digitarhythm/TReK_withTK/media/BOOTH用/PXL_20240208_152246339.jpg

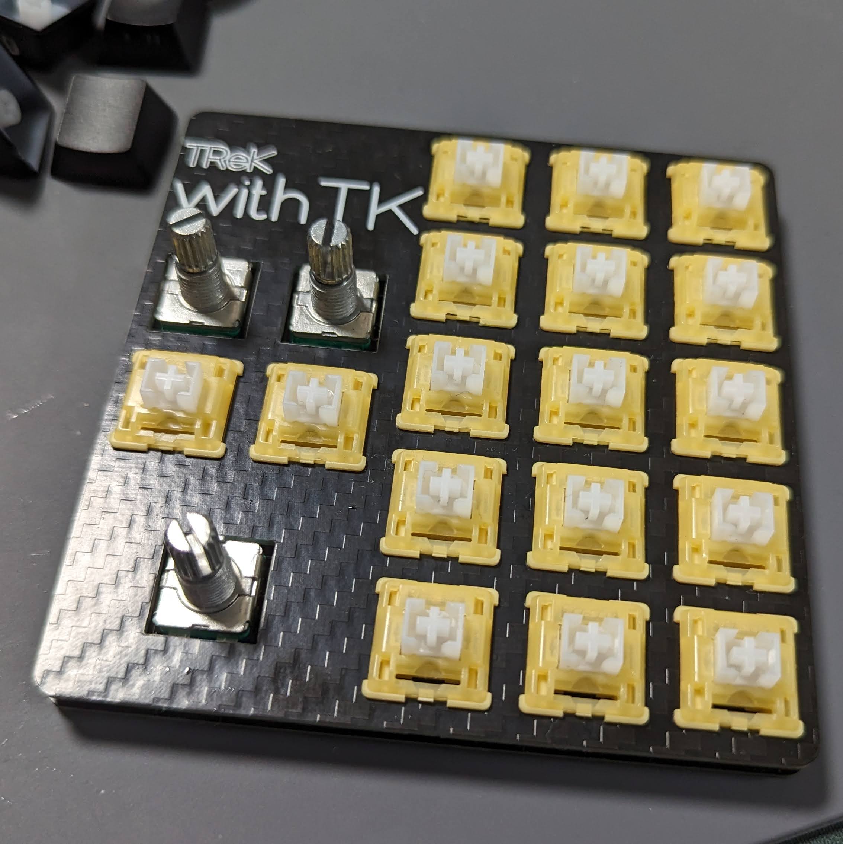
media/BOOTH用/PXL_20240208_152246339.jpg
