digitarhythm/TReK_withTK/media/IMG_20240205_005419.jpg

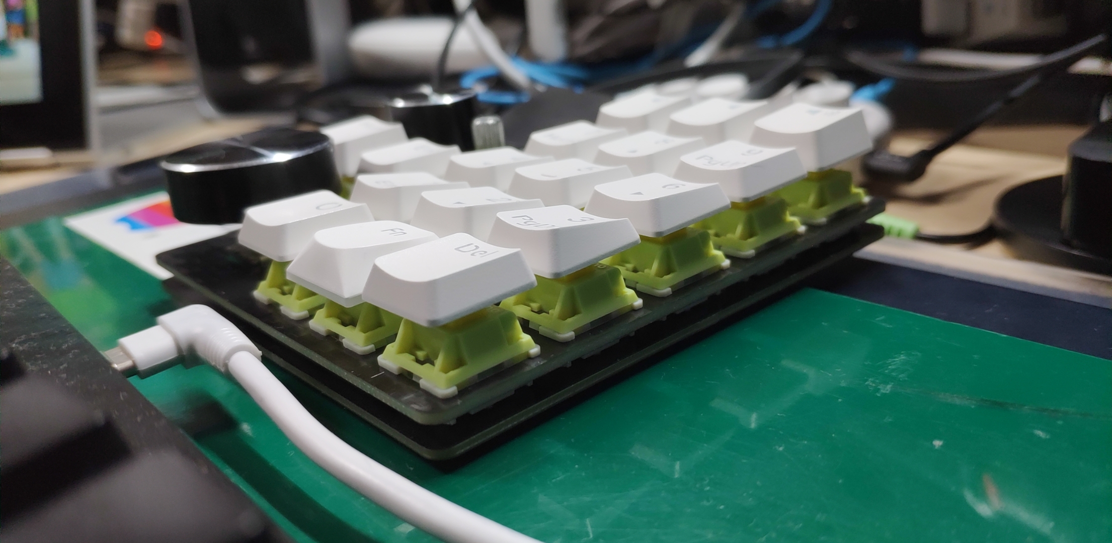
media/IMG_20240205_005419.jpg
