digitarhythm/TReK_withTK/README.md

# TReK withTK
Macropad TenKey pad with RP2040-Zero.

[Firmware repository](https://github.com/digitarhythm/qmk_firmware/tree/digitarhythm/keyboards/trek/withtk)
