digitarhythm/TReK_withTK/media/BOOTH用/IMG_20240203_142107.jpg

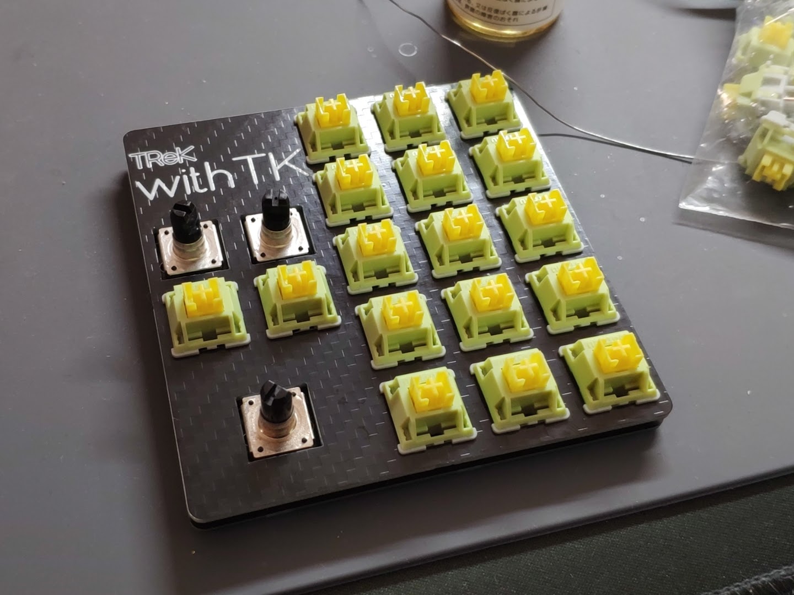
media/BOOTH用/IMG_20240203_142107.jpg
