digitarhythm/TReK_withTK/media/BOOTH用/IMG_20240204_002117.jpg

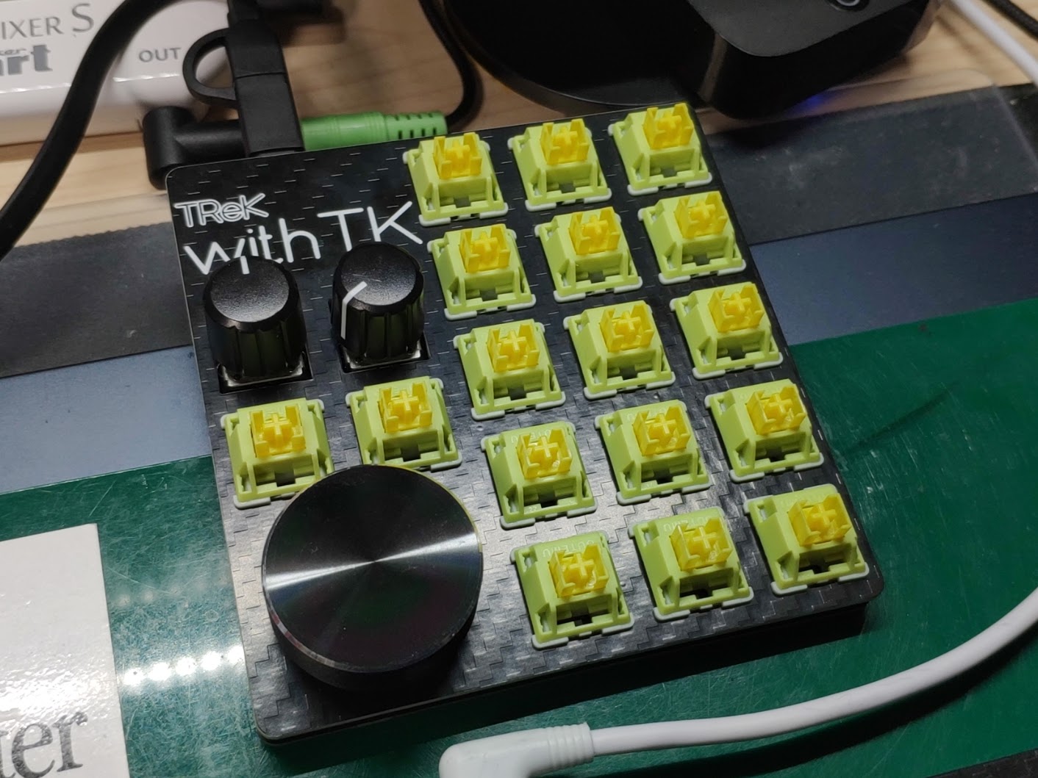
media/BOOTH用/IMG_20240204_002117.jpg
