digitarhythm/TReK_withTK/media/BOOTH用/IMG_20240206_234523.jpg

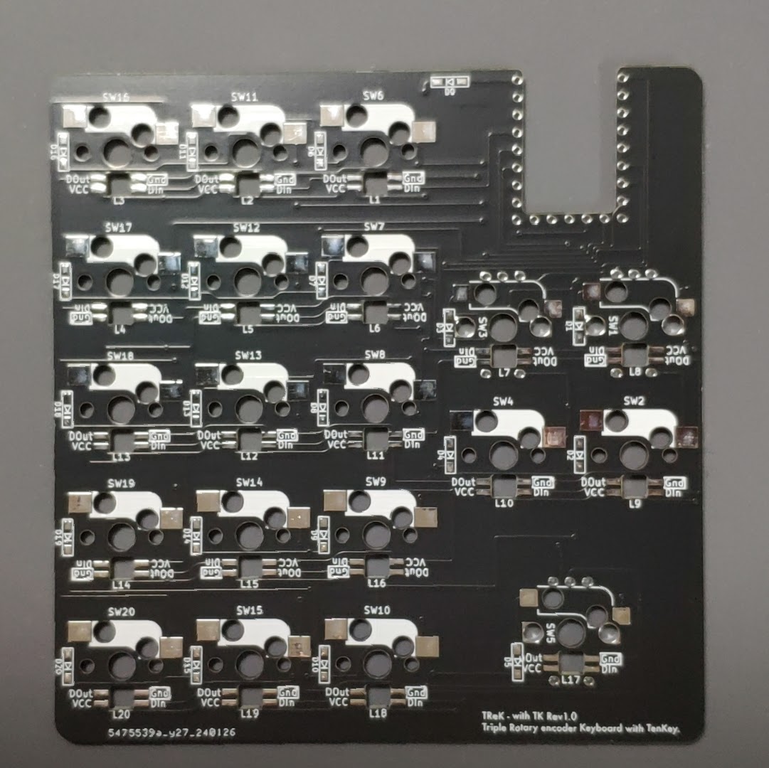
media/BOOTH用/IMG_20240206_234523.jpg
