digitarhythm/TReK_withTK/media/BOOTH用/IMG_20240206_235231.jpg

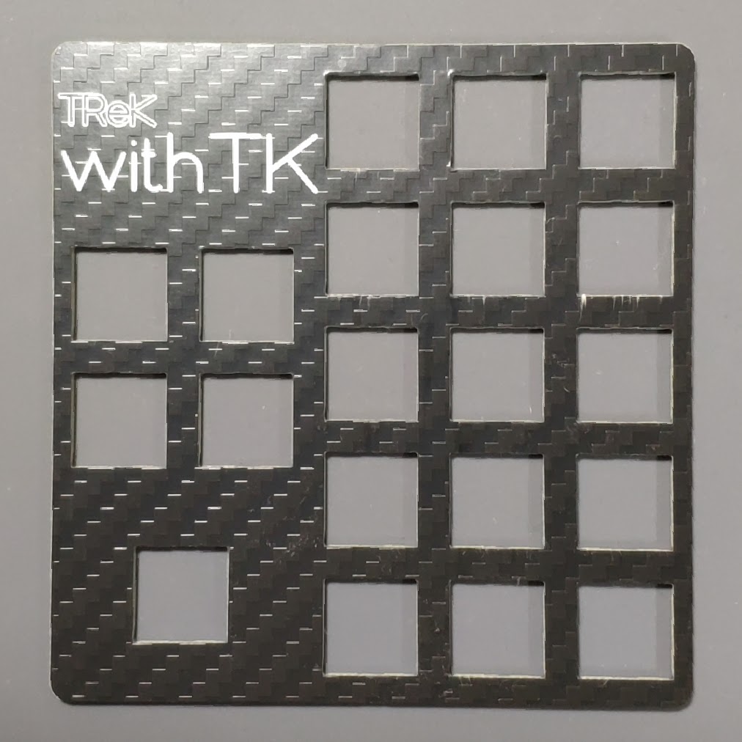
media/BOOTH用/IMG_20240206_235231.jpg
