digitarhythm/TReK_withTK/media/BOOTH用/original_1f7eefd0-b8d7-42fd-86b8-c95d16b6a875_IMG_20240207_214912.jpg

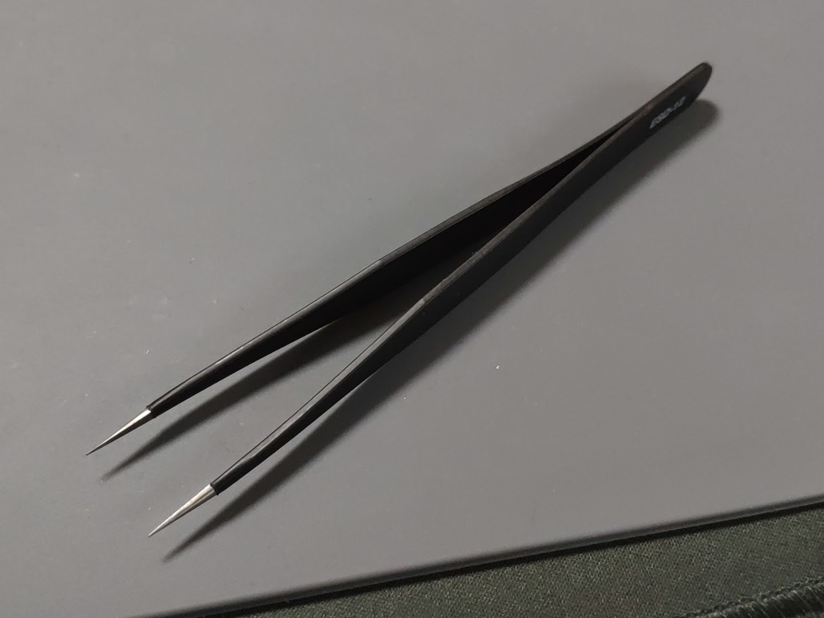
media/BOOTH用/original_1f7eefd0-b8d7-42fd-86b8-c95d16b6a875_IMG_20240207_214912.jpg
