digitarhythm/TReK_withTK/media/BOOTH用/PXL_20240208_113437173.jpg

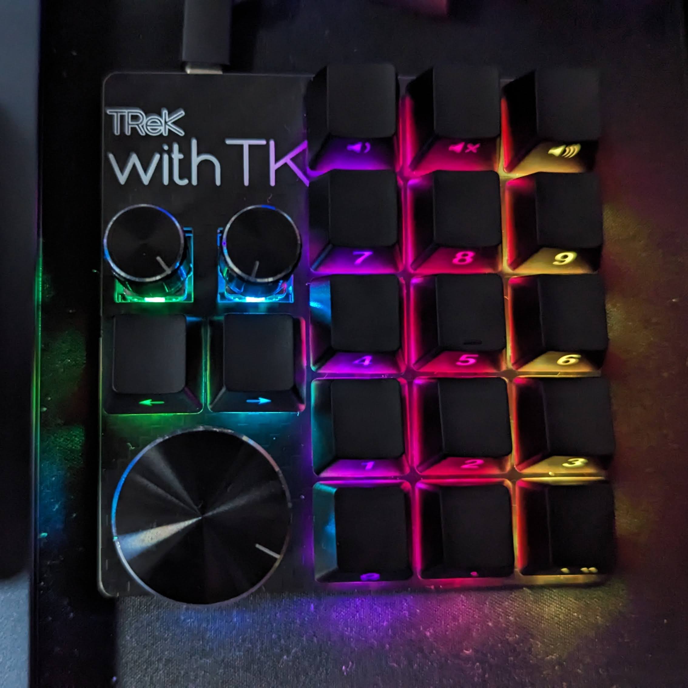
media/BOOTH用/PXL_20240208_113437173.jpg
