digitarhythm/TReK_withTK/media/BOOTH用/PXL_20240208_113447430.jpg

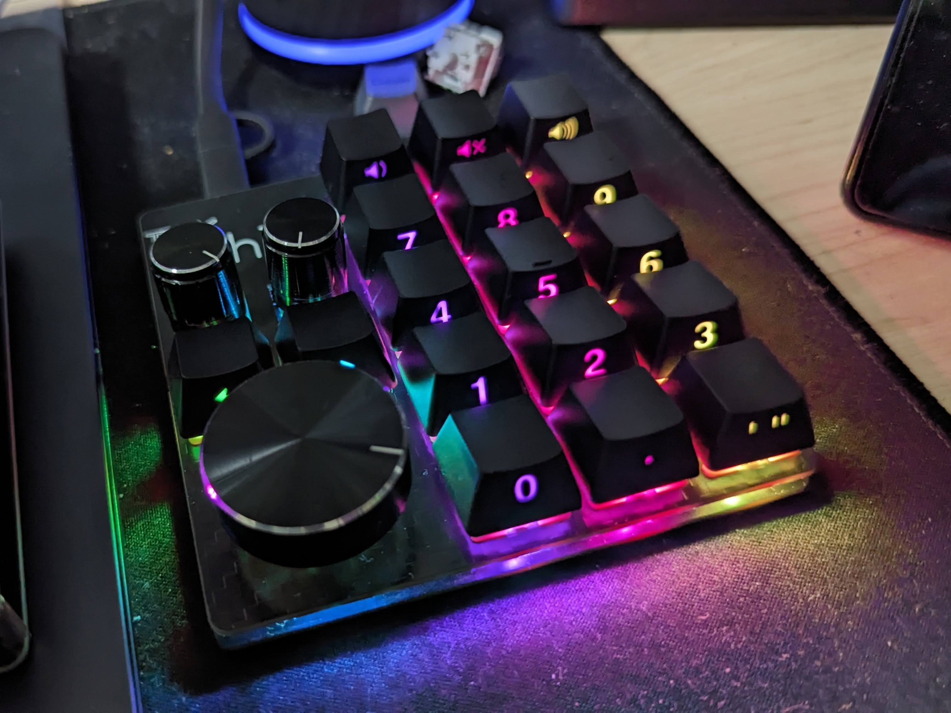
media/BOOTH用/PXL_20240208_113447430.jpg
