digitarhythm/TReK_withTK/media/IMG_20240205_021253.jpg

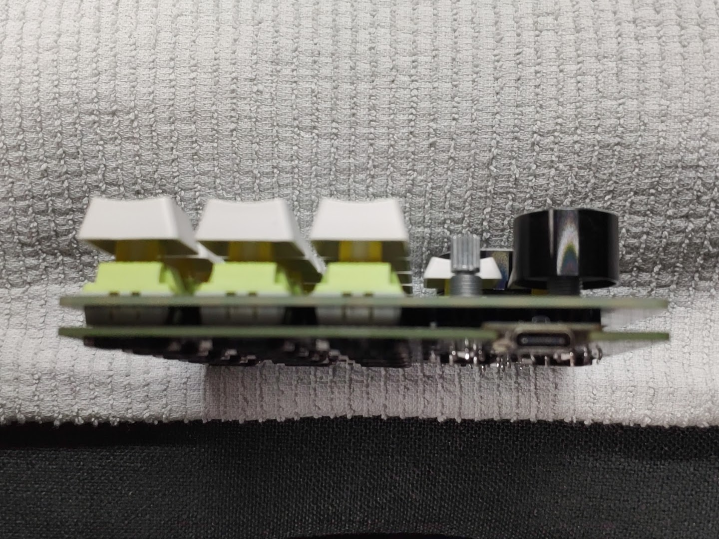
media/IMG_20240205_021253.jpg
