digitarhythm/TReK_withTK/media/withTK.png

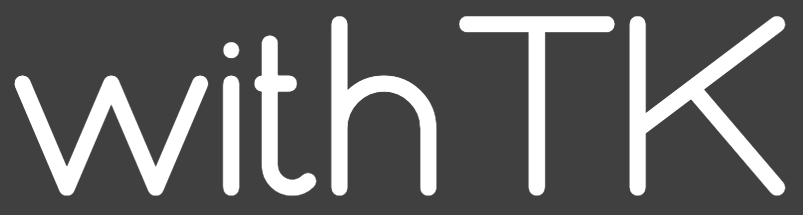
media/withTK.png
