digitarhythm/TReK_withTK/(list of files, drawings)

Other design files:
pcb/withTK.dsn
switch_plate/withTK.dsn
