digitarhythm/TReK_withTK/pcb/withTK.kicad_pcb

## KiCad design pcb/withTK.kicad_pcb (2024-02-04)

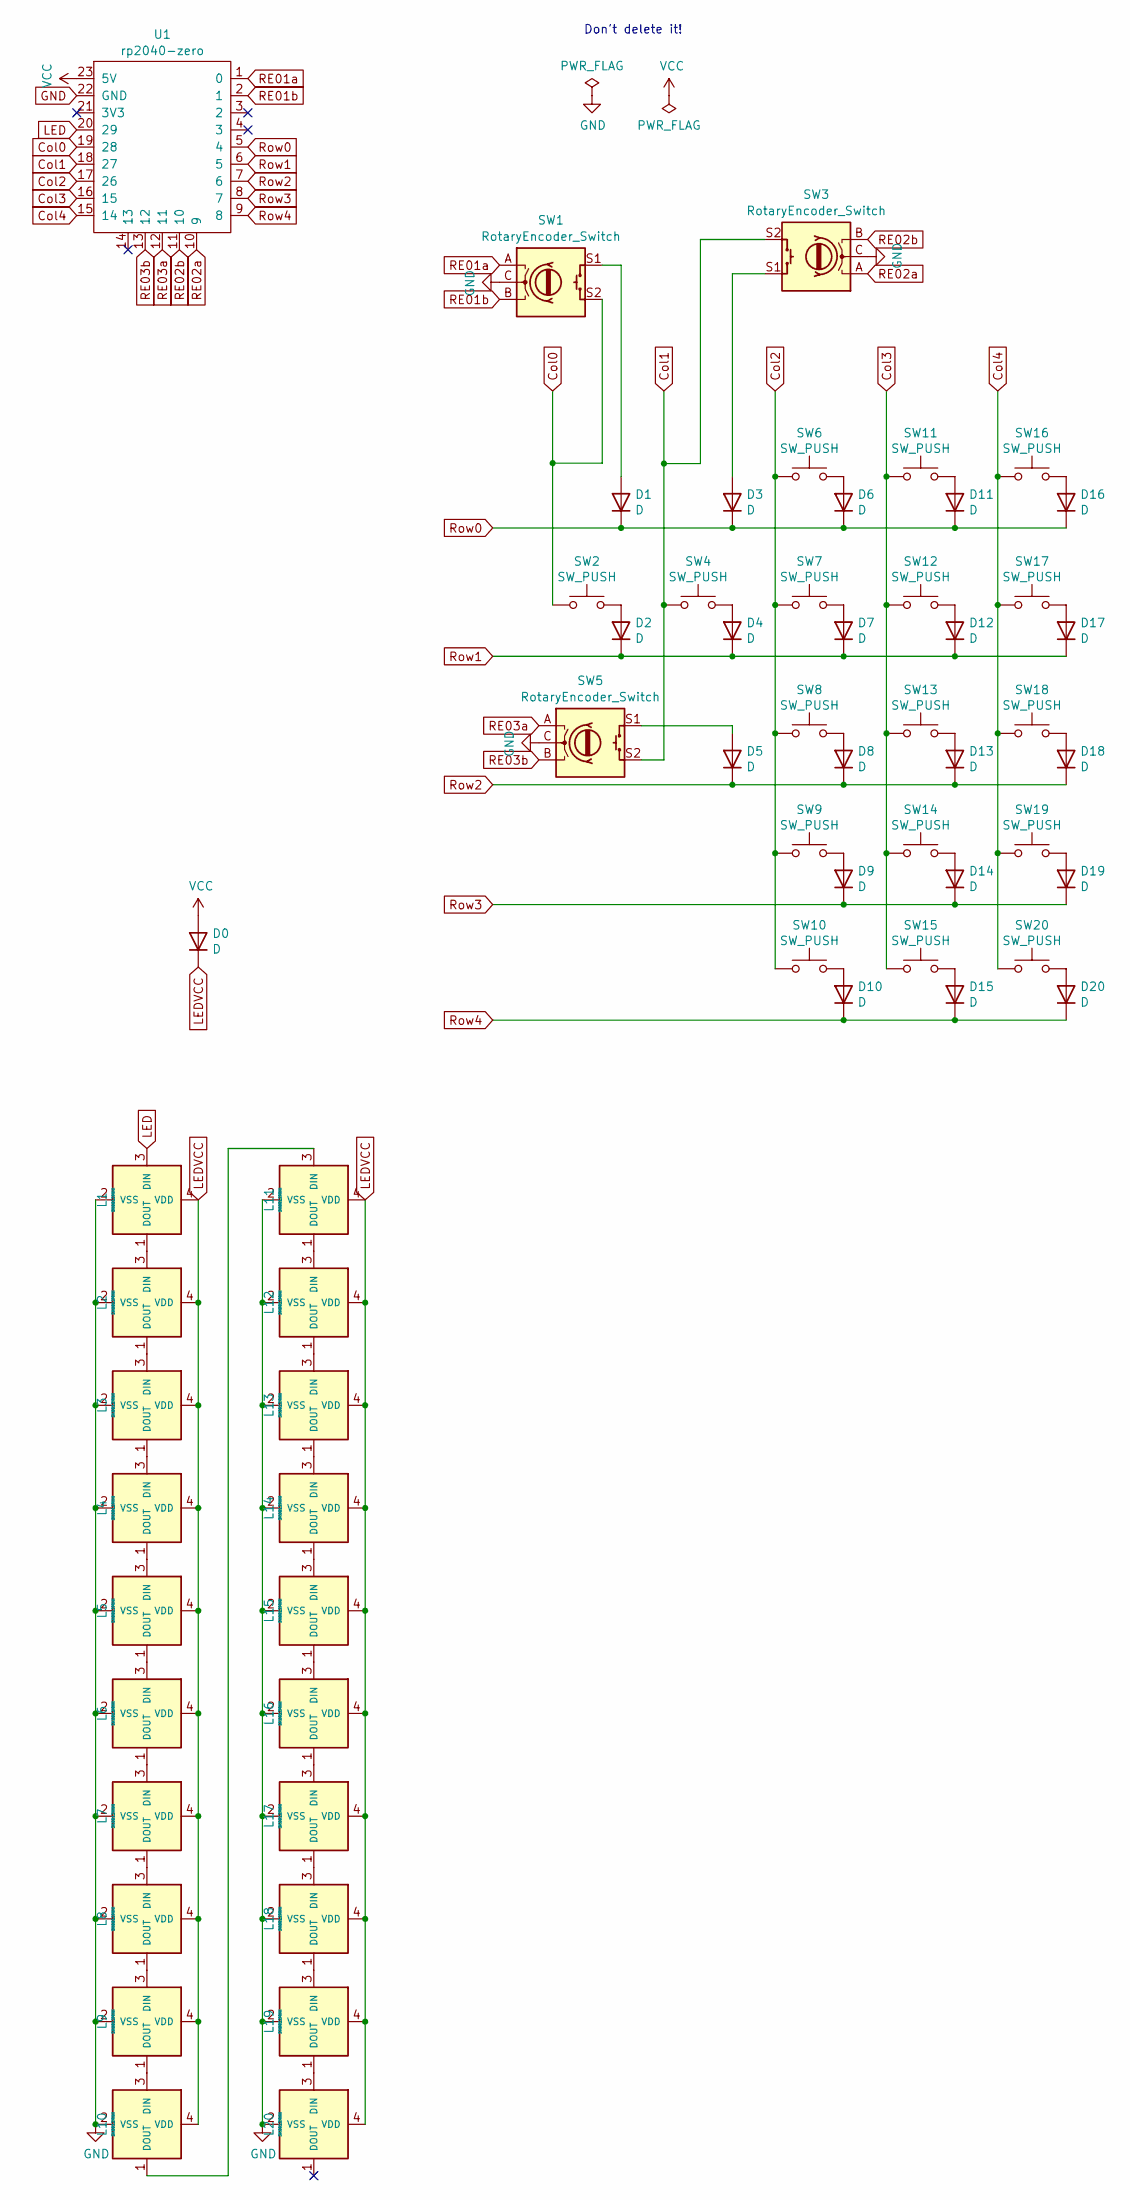
[picture p14: schematic withTK.kicad_sch]

Parts:
D0, D1, D2, D3, D4, D5, D6, D7, D8, D9, D10, D11, D12, D13, D14, D15, D16, D17, D18, D19, D20: D; Diode_SMD
L1, L2, L3, L4, L5, L6, L7, L8, L9, L10, L11, L12, L13, L14, L15, L16, L17, L18, L19, L20: SK6812MINI; LED_SK6812MINI-E_BL
SW1, SW3, SW5: RotaryEncoder_Switch; SW_Cherry_MX_1.00u_Kailh_EC12
SW2, SW4, SW6, SW7, SW8, SW9, SW10, SW11, SW12, SW13, SW14, SW15, SW16, SW17, SW18, SW19, SW20: SW_PUSH; CherryMX_Hotswap_1u
U1: rp2040-zero; rp2040-zero-smd-rev-with-th

Connections:
Col0: SW1.S2, SW2.1, U1.19 (28)
Col1: SW3.S2, SW4.1, SW5.S2, U1.18 (27)
Col2: SW6.1, SW7.1, SW8.1, SW9.1, SW10.1, U1.17 (26)
Col3: SW11.1, SW12.1, SW13.1, SW14.1, SW15.1, U1.16 (15)
Col4: SW16.1, SW17.1, SW18.1, SW19.1, SW20.1, U1.15 (14)
GND: L1.2 (VSS), L2.2 (VSS), L3.2 (VSS), L4.2 (VSS), L5.2 (VSS), L6.2 (VSS), L7.2 (VSS), L8.2 (VSS), L9.2 (VSS), L10.2 (VSS), L11.2 (VSS), L12.2 (VSS), L13.2 (VSS), L14.2 (VSS), L15.2 (VSS), L16.2 (VSS), L17.2 (VSS), L18.2 (VSS), L19.2 (VSS), L20.2 (VSS), SW1.C, SW3.C, SW5.C, U1.22 (GND)
LED: L1.3 (DIN), U1.20 (29)
LEDVCC: D0.1 (K), L1.4 (VDD), L2.4 (VDD), L3.4 (VDD), L4.4 (VDD), L5.4 (VDD), L6.4 (VDD), L7.4 (VDD), L8.4 (VDD), L9.4 (VDD), L10.4 (VDD), L11.4 (VDD), L12.4 (VDD), L13.4 (VDD), L14.4 (VDD), L15.4 (VDD), L16.4 (VDD), L17.4 (VDD), L18.4 (VDD), L19.4 (VDD), L20.4 (VDD)
unnamed: D1.2 (A), SW1.S1
unnamed: D2.2 (A), SW2.2
unnamed: D3.2 (A), SW3.S1
unnamed: D4.2 (A), SW4.2
unnamed: D5.2 (A), SW5.S1
unnamed: D6.2 (A), SW6.2
unnamed: D7.2 (A), SW7.2
unnamed: D8.2 (A), SW8.2
unnamed: D9.2 (A), SW9.2
unnamed: D10.2 (A), SW10.2
unnamed: D11.2 (A), SW11.2
unnamed: D12.2 (A), SW12.2
unnamed: D13.2 (A), SW13.2
unnamed: D14.2 (A), SW14.2
unnamed: D15.2 (A), SW15.2
unnamed: D16.2 (A), SW16.2
unnamed: D17.2 (A), SW17.2
unnamed: D18.2 (A), SW18.2
unnamed: D19.2 (A), SW19.2
unnamed: D20.2 (A), SW20.2
unnamed: L1.1 (DOUT), L2.3 (DIN)
unnamed: L2.1 (DOUT), L3.3 (DIN)
unnamed: L3.1 (DOUT), L4.3 (DIN)
unnamed: L4.1 (DOUT), L5.3 (DIN)
unnamed: L5.1 (DOUT), L6.3 (DIN)
unnamed: L6.1 (DOUT), L7.3 (DIN)
unnamed: L7.1 (DOUT), L8.3 (DIN)
unnamed: L8.1 (DOUT), L9.3 (DIN)
unnamed: L9.1 (DOUT), L10.3 (DIN)
unnamed: L10.1 (DOUT), L11.3 (DIN)
unnamed: L11.1 (DOUT), L12.3 (DIN)
unnamed: L12.1 (DOUT), L13.3 (DIN)
unnamed: L13.1 (DOUT), L14.3 (DIN)
unnamed: L14.1 (DOUT), L15.3 (DIN)
unnamed: L15.1 (DOUT), L16.3 (DIN)
unnamed: L16.1 (DOUT), L17.3 (DIN)
unnamed: L17.1 (DOUT), L18.3 (DIN)
unnamed: L18.1 (DOUT), L19.3 (DIN)
unnamed: L19.1 (DOUT), L20.3 (DIN)
RE01a: SW1.A, U1.1 (0)
RE01b: SW1.B, U1.2 (1)
RE02a: SW3.A, U1.10 (9)
RE02b: SW3.B, U1.11 (10)
RE03a: SW5.A, U1.12 (11)
RE03b: SW5.B, U1.13 (12)
Row0: D1.1 (K), D3.1 (K), D6.1 (K), D11.1 (K), D16.1 (K), U1.5 (4)
Row1: D2.1 (K), D4.1 (K), D7.1 (K), D12.1 (K), D17.1 (K), U1.6 (5)
Row2: D5.1 (K), D8.1 (K), D13.1 (K), D18.1 (K), U1.7 (6)
Row3: D9.1 (K), D14.1 (K), D19.1 (K), U1.8 (7)
Row4: D10.1 (K), D15.1 (K), D20.1 (K), U1.9 (8)
VCC: D0.2 (A), U1.23 (5V)

Notes on the sheet:
Don't delete it!

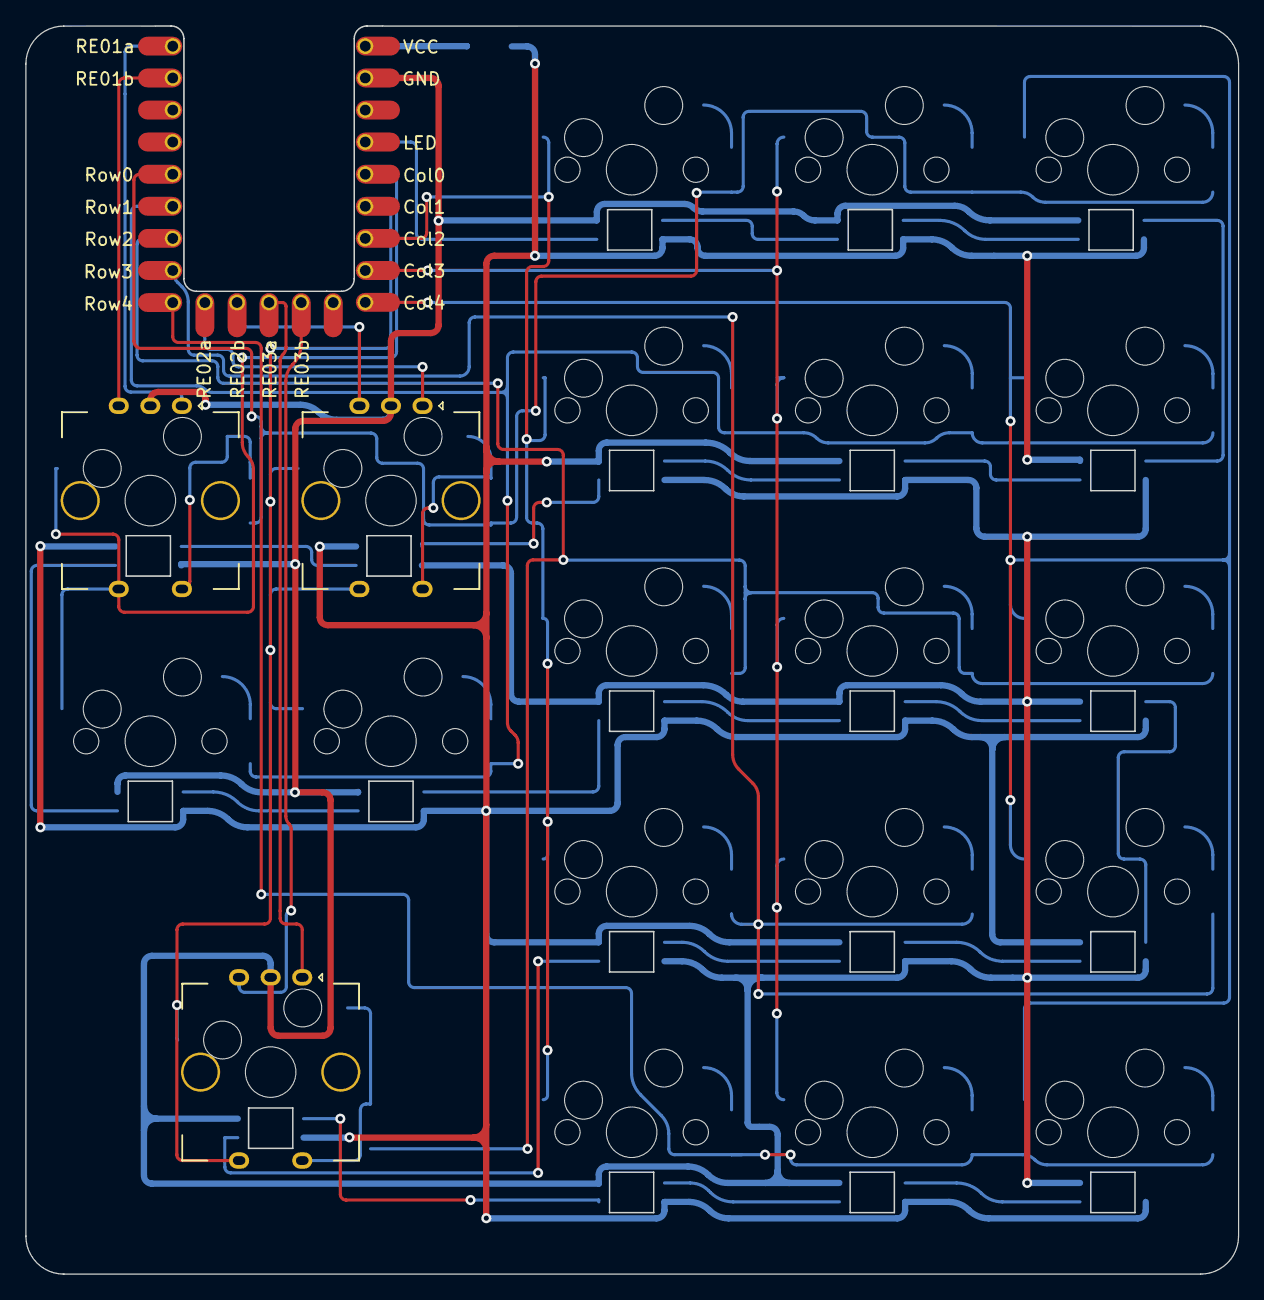
[picture p15: board withTK.kicad_pcb from above]

Board: 2 copper layers, 96.0 x 98.8 mm, 62 parts (0 on the bottom side), 59 nets.
