digitarhythm/TReK_withTK/Firmware/trek_withtk/keymaps/default/config.h

#pragma once

#define TAPPING_TERM 200
#define HOLD_ON_OTHER_KEY_PRESS
#define TAPPING_FORCE_HOLD

#ifdef RGBLED_NUM
  #undef RGBLED_NUM
#endif

#define RGB_MATRIX_LED_COUNT 20

#ifdef RGB_MATRIX_ENABLE
  #define RGB_DISABLE_WHEN_USB_SUSPENDED
  #define RGB_MATRIX_KEYPRESSES
  #define RGB_MATRIX_LED_PROCESS_LIMIT (RGB_MATRIX_LED_COUNT + 4) / 5
  #define RGB_MATRIX_LED_FLUSH_LIMIT 16
  #define RGB_MATRIX_MAXIMUM_BRIGHTNESS 200
  #define RGB_MATRIX_DEFAULT_HUE 0
  #define RGB_MATRIX_DEFAULT_SAT 255
  #define RGB_MATRIX_DEFAULT_VAL 50
  #define RGB_MATRIX_DEFAULT_SPD 127

  #define ENABLE_RGB_MATRIX_ALPHAS_MODS
  #define ENABLE_RGB_MATRIX_GRADIENT_UP_DOWN
  #define ENABLE_RGB_MATRIX_GRADIENT_LEFT_RIGHT
  #define ENABLE_RGB_MATRIX_BREATHING
  #define ENABLE_RGB_MATRIX_BAND_SAT
  #define ENABLE_RGB_MATRIX_BAND_VAL
  #define ENABLE_RGB_MATRIX_BAND_PINWHEEL_SAT
  #define ENABLE_RGB_MATRIX_BAND_PINWHEEL_VAL
  #define ENABLE_RGB_MATRIX_BAND_SPIRAL_SAT
  #define ENABLE_RGB_MATRIX_BAND_SPIRAL_VAL
  #define ENABLE_RGB_MATRIX_CYCLE_ALL
  #define ENABLE_RGB_MATRIX_CYCLE_LEFT_RIGHT
  #define ENABLE_RGB_MATRIX_CYCLE_UP_DOWN
  #define ENABLE_RGB_MATRIX_RAINBOW_MOVING_CHEVRON
  #define ENABLE_RGB_MATRIX_CYCLE_OUT_IN
  #define ENABLE_RGB_MATRIX_CYCLE_OUT_IN_DUAL
  #define ENABLE_RGB_MATRIX_CYCLE_PINWHEEL
  #define ENABLE_RGB_MATRIX_CYCLE_SPIRAL
  #define ENABLE_RGB_MATRIX_DUAL_BEACON
  #define ENABLE_RGB_MATRIX_RAINBOW_BEACON
  #define ENABLE_RGB_MATRIX_RAINBOW_PINWHEELS
  #define ENABLE_RGB_MATRIX_RAINDROPS
  #define ENABLE_RGB_MATRIX_JELLYBEAN_RAINDROPS
  #define ENABLE_RGB_MATRIX_HUE_BREATHING
  #define ENABLE_RGB_MATRIX_HUE_PENDULUM
  #define ENABLE_RGB_MATRIX_HUE_WAVE
  #define ENABLE_RGB_MATRIX_PIXEL_FRACTAL
  #define ENABLE_RGB_MATRIX_PIXEL_FLOW
  #define ENABLE_RGB_MATRIX_PIXEL_RAIN
  #define ENABLE_RGB_MATRIX_TYPING_HEATMAP
  #define ENABLE_RGB_MATRIX_DIGITAL_RAIN
  #define ENABLE_RGB_MATRIX_SOLID_REACTIVE_SIMPLE
  #define ENABLE_RGB_MATRIX_SOLID_REACTIVE
  #define ENABLE_RGB_MATRIX_SOLID_REACTIVE_WIDE
  #define ENABLE_RGB_MATRIX_SOLID_REACTIVE_MULTIWIDE
  #define ENABLE_RGB_MATRIX_SOLID_REACTIVE_CROSS
  #define ENABLE_RGB_MATRIX_SOLID_REACTIVE_MULTICROSS
  #define ENABLE_RGB_MATRIX_SOLID_REACTIVE_NEXUS
  #define ENABLE_RGB_MATRIX_SOLID_REACTIVE_MULTINEXUS
  #define ENABLE_RGB_MATRIX_SPLASH
  #define ENABLE_RGB_MATRIX_MULTISPLASH
  #define ENABLE_RGB_MATRIX_SOLID_SPLASH
  #define ENABLE_RGB_MATRIX_SOLID_MULTISPLASH
#endif

#define LAYOUT_withtk( \
  K00, K01, K02, K03, K04, \
  K10, K11, K12, K13, K14, \
  K20, K21, K22, K23, K24, \
  K30, K31, K32, K33, K34, \
  K40, K41, K42, K43, K44  \
) \
{ \
  {   K00,   K01,   K02,   K03,   K04 }, \
  {   K10,   K11,   K12,   K13,   K14 }, \
  { KC_NO,   K21,   K22,   K23,   K24 }, \
  { KC_NO, KC_NO,   K32,   K33,   K34 }, \
  { KC_NO, KC_NO,   K42,   K43,   K44 } \
}
